AdavVegab/LoRaWAN_embeddedSystems/Präsi/Präsentation_10_12_2019.pptx

## Embedded Systems

- Energieautarke Feinstaubmessung

Thorben Kompalla
Andres Gallego
Nils Hamsen
Andres Vega
Philipp Wolters
Roman Lütkenhaus

- 10.12.2019

## Energieautarke Feinstaubmessung

- Übersicht

- Produktübersicht
- Hardwarekonzept
- Platinenlayout
- Firmware auf dem Mikrocontroller
- TTN – Anbindung und Darstellung der Daten

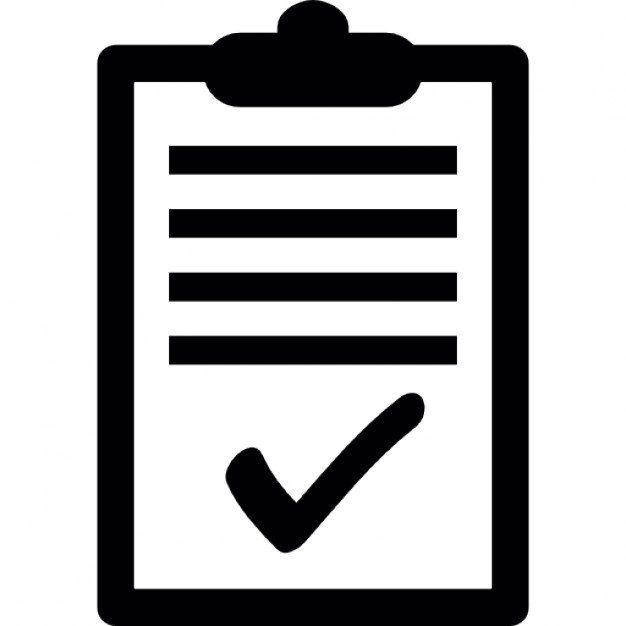
[picture p1: figure]

## Energieautarke Feinstaubmessung

- Produktübersicht

- Mobile Feinstaubmessung
- Stromversorgung über Akku und Solarzelle
- Darstellung der Messwerte auf einer Karte

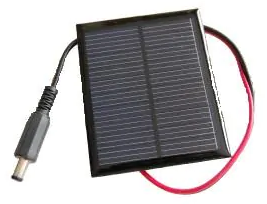
[picture p2: figure]
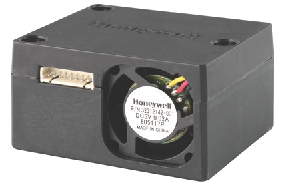
[picture p3: figure]

## Energieautarke Feinstaubmessung

- Hardwarekonzept

- Aufladung eines Akkus über Solarzelle
  - Step-Up-Converter und Lademanagement-Controller
- 3.3 V und 5 V Spannungsebenen durch Festspannungsregler
- Anbindung von Sensoren über 2 UART
- LoRaWAN-Modul über SPI angebunden

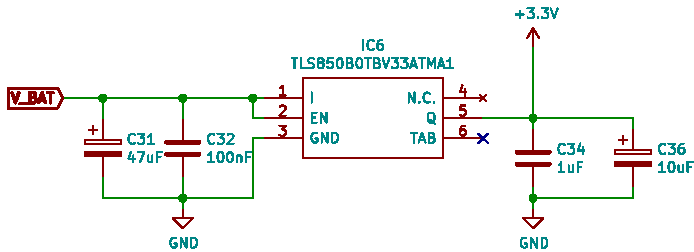
[picture p4: figure]

## Energieautarke Feinstaubmessung

- Platinenlayout

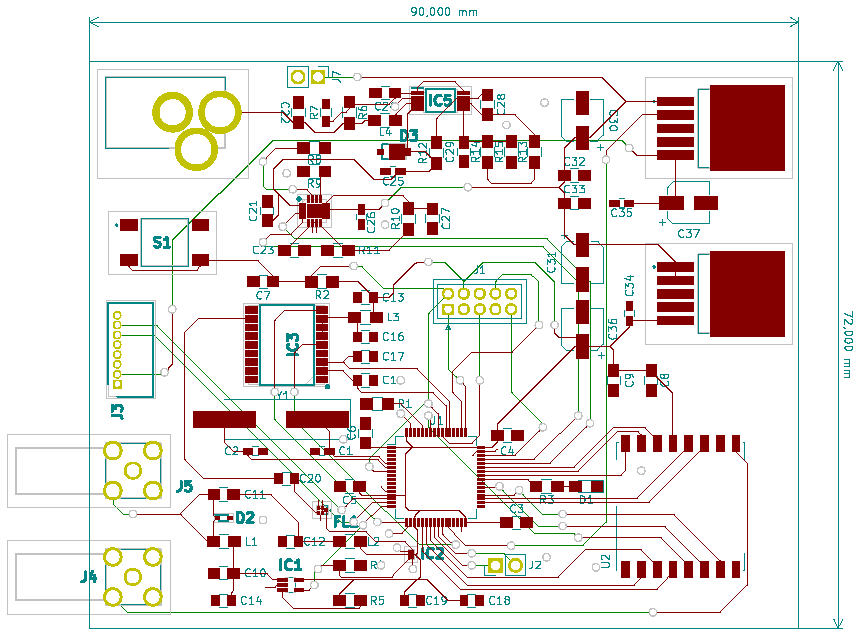
[picture p5: figure]

## Energieautarke Feinstaubmessung

- Platinenlayout

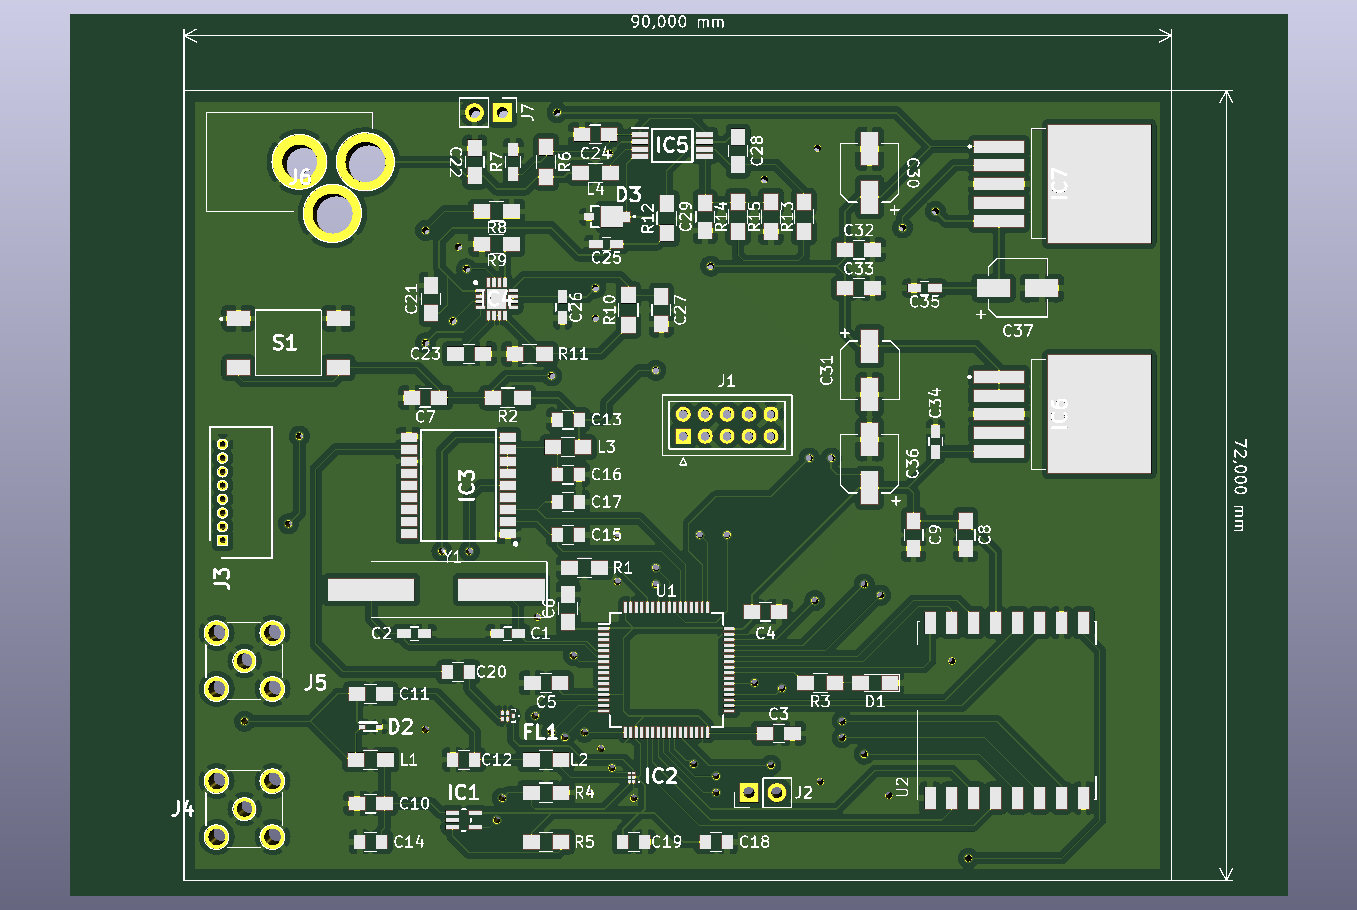
[picture p6: figure]

## Energieautarke Feinstaubmessung

- Firmware

  - LMIC-Bibliothek für LoRaWAN-Kommunikation
    - Betriebssystem regelt Jobs
    - Senden von DataFrames an TTN funktioniert
  - UART-Kommunikation mit Feinstaubsensor getestet
  - GPS-Kommunikation ist noch in Entwicklung

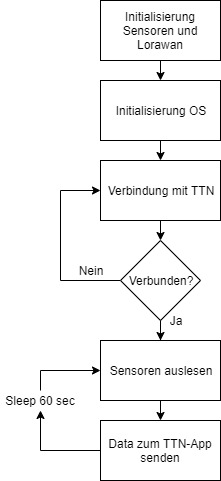
[picture p7: figure]

## Energieautarke Feinstaubmessung

- TTN – Anbindung und Darstellung der Daten
- DEMO

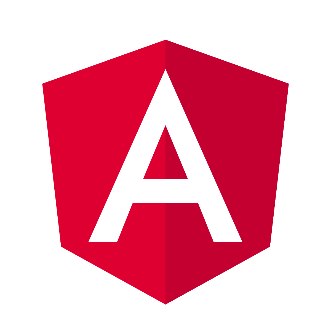
[picture p8: figure]
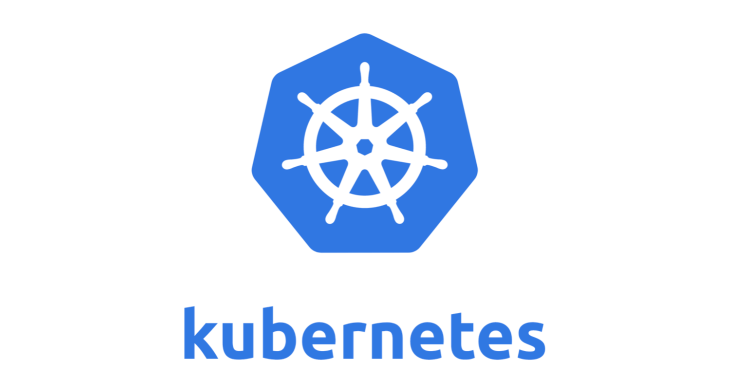
[picture p9: figure]

## Slide 9

Danke für die Aufmerksamkeit!
