AdavVegab/LoRaWAN_embeddedSystems/Präsi/SC10036_SPL.jpg

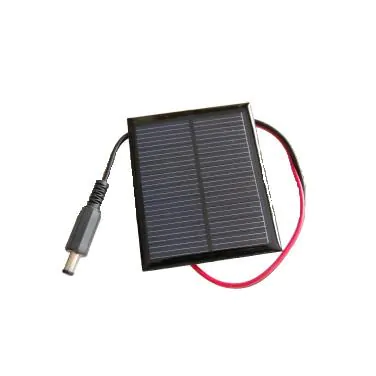
Präsi/SC10036_SPL.jpg
