AdavVegab/LoRaWAN_embeddedSystems/Schaltplan_embedded/KiCad/ES_proj_LoRaWAN_fsm/Schaltplan_embedded.png

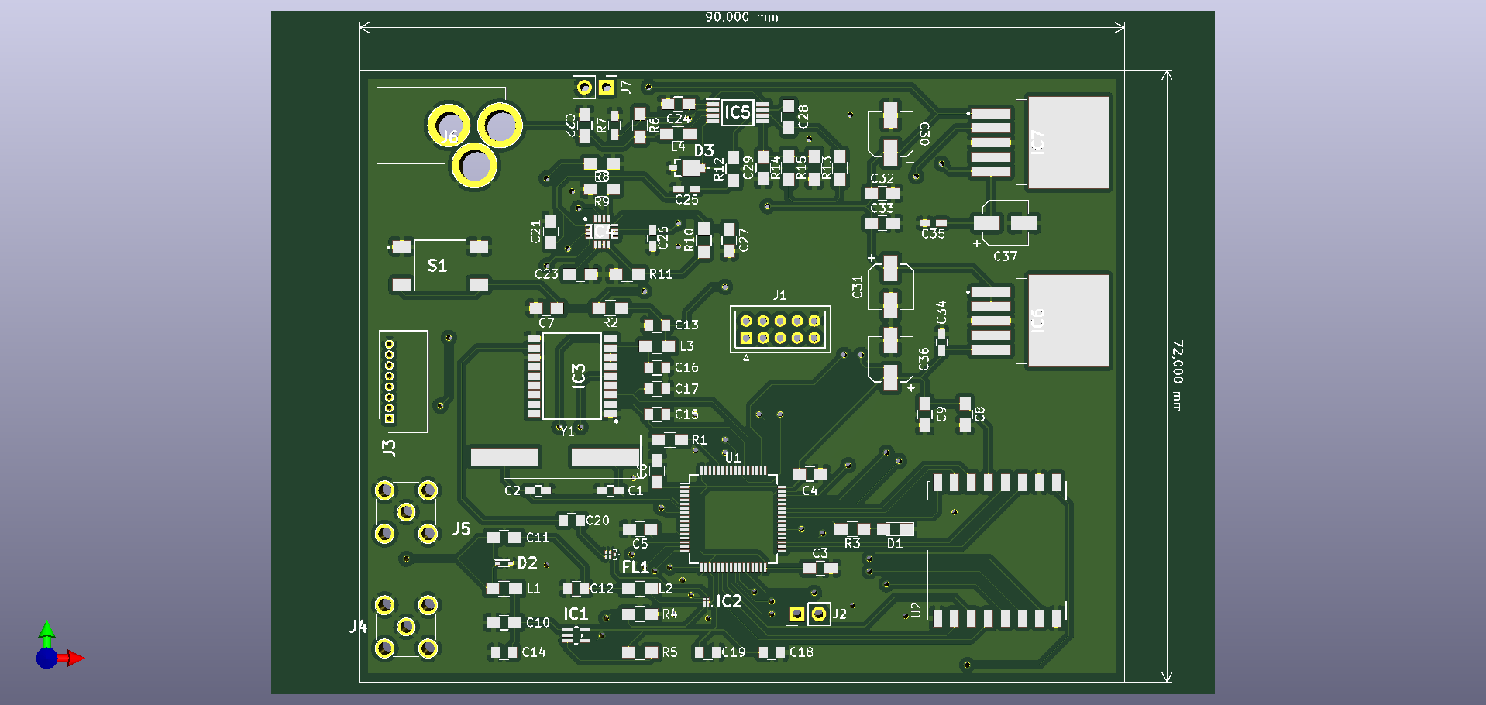
Schaltplan_embedded/KiCad/ES_proj_LoRaWAN_fsm/Schaltplan_embedded.png
