AdavVegab/LoRaWAN_embeddedSystems/Stückliste/ES_Stückliste_G3_30-10-19.xlsx

Nr. | Bauteil | Artikelnummer (Mouser) | Bezeichnung | Link | Anzahl | Stückpreis | Gesamtpreis
1 | GPS-Modul | 511-TESEO-LIV3F | Teseo-LIV3F | https://www.mouser.de/ProductDetail/STMicroelectronics/TESEO-LIV3F | 1 | 12.80 € | 12.80 €
2 | Luftqualitätssensor | 785-HPMA115SO-XXX | HPMA115S0-XXX | https://www.mouser.de/ProductDetail/Honeywell/HPMA115S0-XXX | 1 | 36.22 € | 36.22 €
3 | Akkumulator | 406-ASR00011 | ASR00011 | https://www.mouser.de/ProductDetail/TinyCircuits/ASR00011 | 1 | 2.44 € | 2.44 €
4 | Solarzelle | 375-SC10036 | SC10036 | https://www.mouser.de/ProductDetail/OSEPP-Electronics/SC10036 | 1 | 6.29 € | 6.29 €
5 | Batteriemanagement-IC | 511-SPV1040T | SPV1040T | https://www.mouser.de/ProductDetail/STMicroelectronics/SPV1040T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 | 1 | 2.84 € | 2.84 €
6 | Spannungsregler | 726-TLS850B0TBV33ATM | TLS850B0TBV33ATMA1 | https://www.mouser.de/ProductDetail/Infineon-Technologies/TLS850B0TBV33ATMA1 | 1 | 1.40 € | 1.40 €
7 | Spannungsregler | 726-TLS850B0TBV50ATM | TLS850B0TBV50ATMA1 | https://www.mouser.de/ProductDetail/Infineon-Technologies/TLS850B0TBV50ATMA1 | 1 | 1.40 € | 1.40 €
8 | Test-Board GPS | 511-X-NUCLEO-GNSS1A1 | X-NUCLEO-GNSS1A1 | https://www.mouser.de/ProductDetail/STMicroelectronics/X-NUCLEO-GNSS1A1 | 1 | 32.76 € | 32.76 €
9 | Battery charger system | 511-L6924D013TR | L6924D013TR | https://www.mouser.de/ProductDetail/STMicroelectronics/L6924D013TR?qs=sGAEpiMZZMuHTYi1bHPYEMtwCS34widI | 1 | 1.68 € | 1.68 €
10 | Antennenanschluss | 523-132289-14 | 132289-14 | https://www.mouser.de/ProductDetail/Amphenol-RF/132289-14 | 1 | 7.51 € | 7.51 €
11 | Low Noise Amplifier | 726-BGA824N6E6327 | BGA 824N6 E6327 | https://www.mouser.de/ProductDetail/Infineon-Technologies/BGA-824N6-E6327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 | 1 | 0.67 € | 0.67 €
12 | ESD protection | 511-ESDARF02-1BU2CK | ESDARF02-1BU2CK | https://www.mouser.de/ProductDetail/STMicroelectronics/ESDARF02-1BU2CK | 1 | 0.31 € | 0.31 €
13 | Low-input-voltageCurrent-limitedLoad Switches | 595-TPS22943DCKR | TPS22943DCKR | https://www.mouser.de/ProductDetail/Texas-Instruments/TPS22943DCKR | 1 | 0.91 € | 0.91 €
14 | GPS-Filter | 871-B39162B4327P810 | B39162B4327P810 | https://www.mouser.de/ProductDetail/RF360/B39162B4327P810?qs=sGAEpiMZZMvfFCidbTccA7zgl7Tx407969qKMV2MTGk%3D | 1 | 1.78 € | 1.78 €
15 | Patch Antenne | 538-206640-0001 | 206640-0001 | https://www.mouser.de/ProductDetail/Molex/206640-0001 | 1 | 5.50 € | 5.50 €
 | Kondensatoren Keramik | Unit | Verpackung | Anzahl | Anzahl Bestellt
 | 1 | nF | 805 | 4
 | 10 | nF | 805 | 2 |  | Gesamt: | 114.51 €
 | 100 | nF | 805 | 8
 | 3.9 | pF | 805 | 1
 | 20 | pF | 805 | 2
 | 56 | pF | 805 | 4
 | 120 | pF | 805 | 2
 | 1 | uF | 805 | 6
 | 2.2 | uF | 805 | 1
 | 4.7 | uF | 805 | 1
 | 10 | uF | 805 | 1
 | 47 | uF | 805 | 1
