AdavVegab/LoRaWAN_embeddedSystems/Gehäuse/mitte.stl

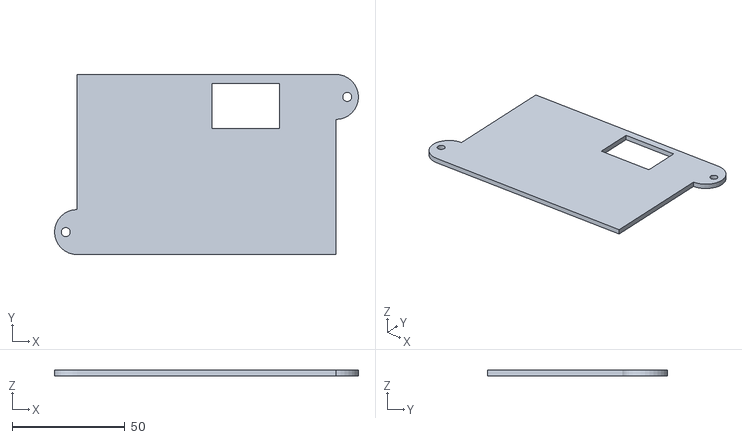
[picture p14: CAD file, 2020-02-01]
Gehäuse/mitte.stl
135.0 x 80.0 x 2.50
