AdavVegab/LoRaWAN_embeddedSystems/modell/TESEO-LIV3F.stp

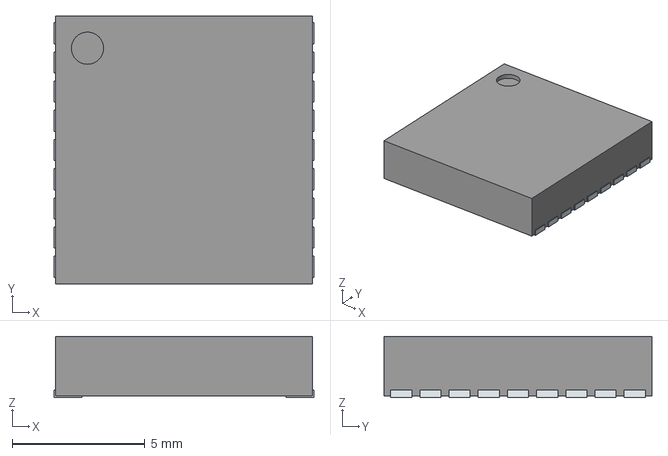
[picture p15: CAD file, 2019-11-13]
modell/TESEO-LIV3F.stp
9.80 x 10.1 x 2.30 mm
PinsArrayLR
