AdavVegab/LoRaWAN_embeddedSystems/Schaltplan_embedded/Bibliothek/modells/ECS-80-12-30Q-DS-TR.stp

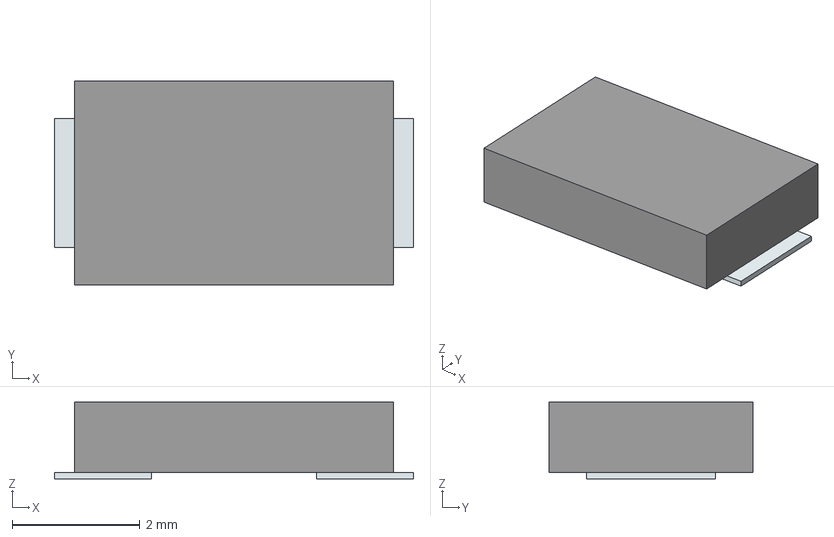
[picture p16: CAD file, 2019-12-11]
Schaltplan_embedded/Bibliothek/modells/ECS-80-12-30Q-DS-TR.stp
5.62 x 3.20 x 1.20 mm
('pin',_'1')
('pin',_'2')
