AdavVegab/LoRaWAN_embeddedSystems/Gehäuse/Gehause.FCStd

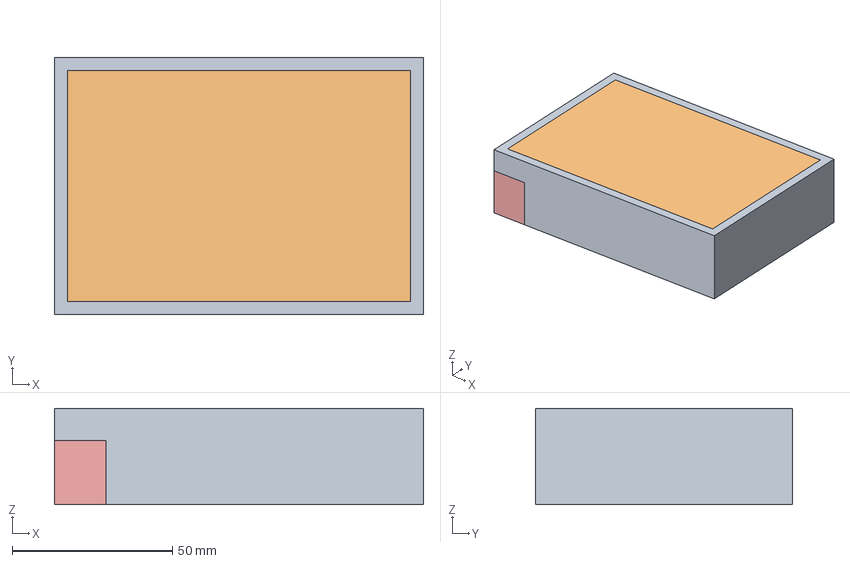
[picture p17: CAD file, 2020-02-01]
Gehäuse/Gehause.FCStd
115.0 x 80.0 x 30.0 mm
Basis
Basis_Cut
Solar
Antenne
Luftsensor
