AdavVegab/LoRaWAN_embeddedSystems/modell/L6924D.stp

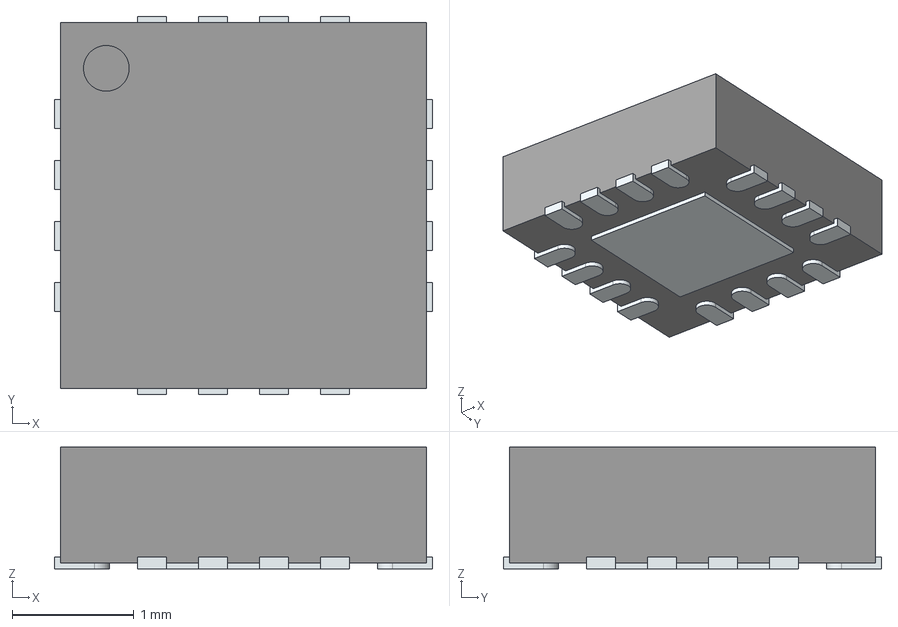
[picture p18: CAD file, 2019-11-13]
modell/L6924D.stp
3.10 x 3.10 x 1.00 mm
ThermalPin
PinsArrayLR
PinsArrayTB
