AdavVegab/LoRaWAN_embeddedSystems/Gehäuse/Case.FCStd

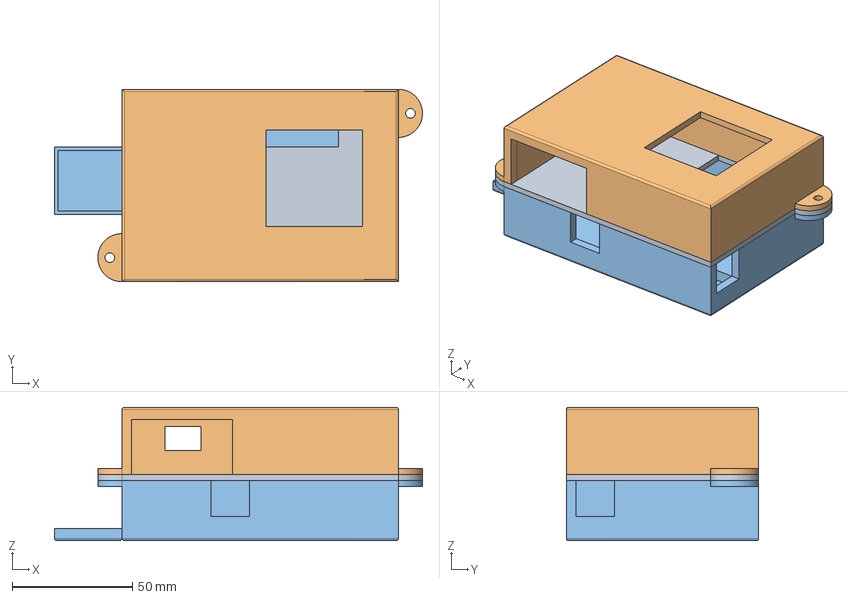
[picture p19: CAD file, 2020-02-01]
Gehäuse/Case.FCStd
153.0 x 80.0 x 55.5 mm
Mitte
Top003
Base001
