AdavVegab/LoRaWAN_embeddedSystems/modell/ESDARF02-1BU2CK.stp

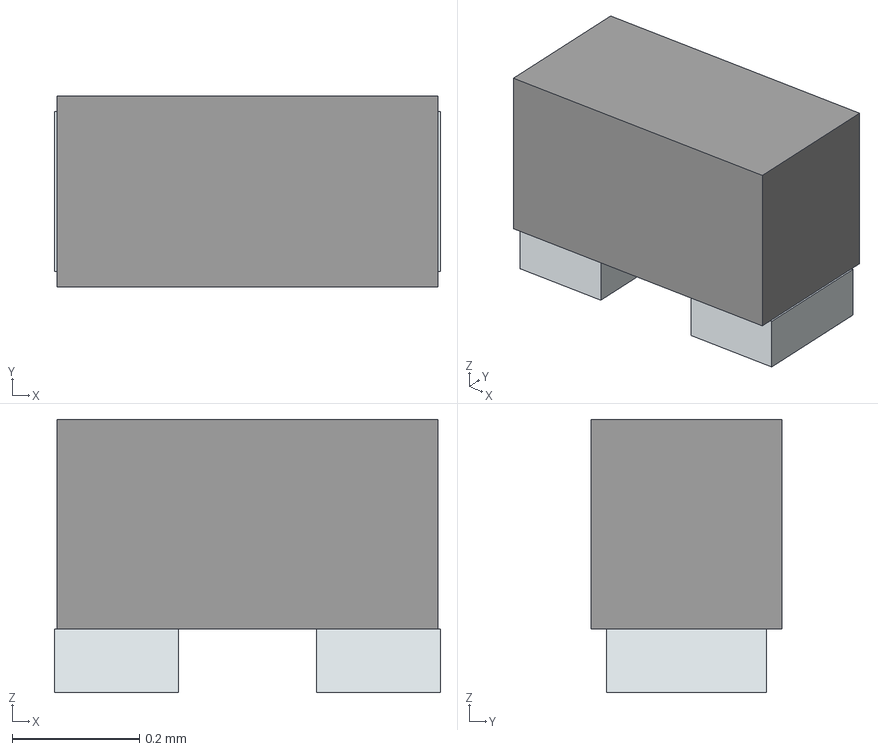
[picture p20: CAD file, 2019-11-13]
modell/ESDARF02-1BU2CK.stp
0.607 x 0.3 x 0.43 mm
('pin',_'1')
('pin',_'2')
