AdavVegab/LoRaWAN_embeddedSystems/Gehäuse/Top.stl

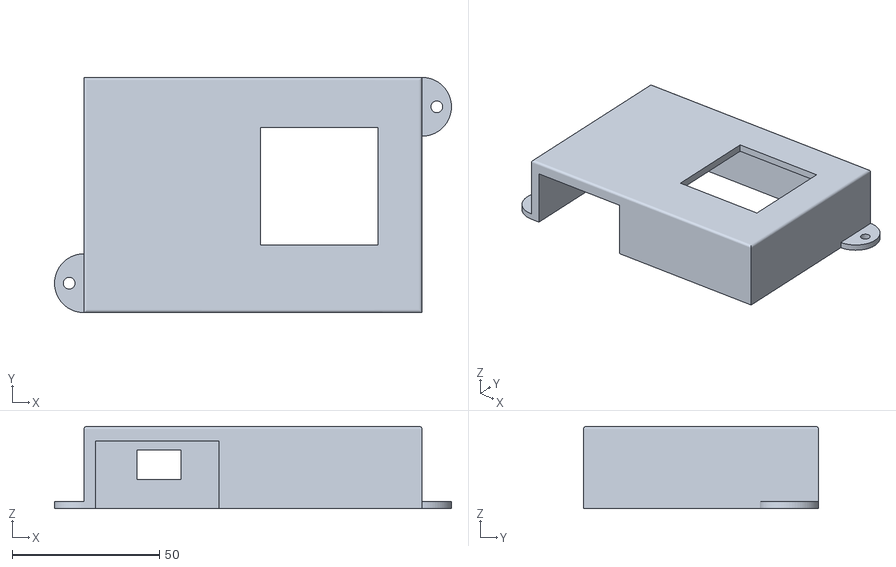
[picture p21: CAD file, 2020-02-01]
Gehäuse/Top.stl
135.0 x 80.0 x 28.0
