AdavVegab/LoRaWAN_embeddedSystems/modell/SPV1040T.stp

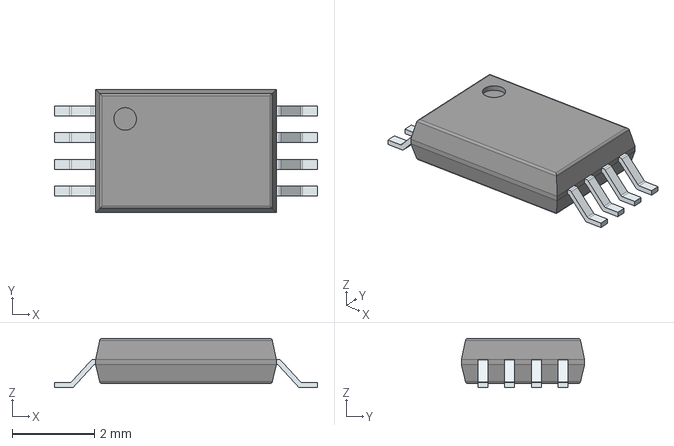
[picture p22: CAD file, 2019-11-05]
modell/SPV1040T.stp
6.40 x 3.00 x 1.20 mm
PinsArrayLR
