AdavVegab/LoRaWAN_embeddedSystems/Gehäuse/Base.stl

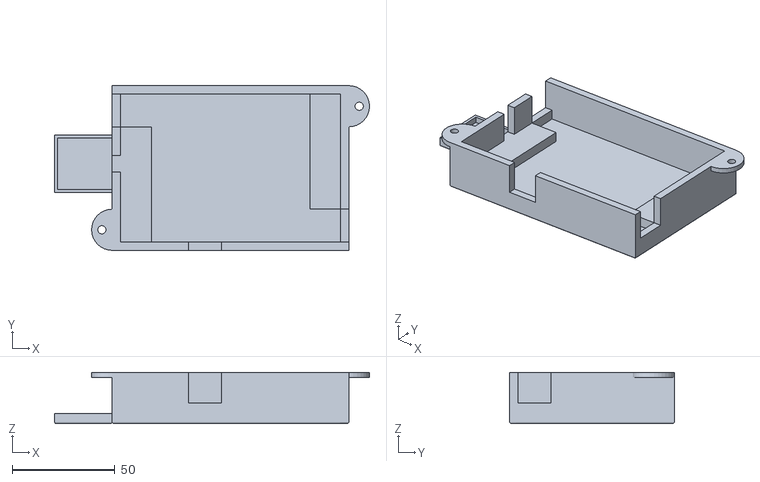
[picture p23: CAD file, 2020-02-01]
Gehäuse/Base.stl
153.0 x 80.0 x 25.0
