AdavVegab/LoRaWAN_embeddedSystems/(list of files, cad)

Other CAD files:
Bibliotheken/73100-0258.stl
Schaltplan_embedded/Bibliothek/modells/ECS-80-12-30Q-DS-TR.stl
modell/ESDARF02-1BU2CK.stl
modell/L6924D.stl
modell/SPV1040T.stl
modell/TESEO-LIV3F.stl
