AdavVegab/LoRaWAN_embeddedSystems/Präsi/Plt.pdf

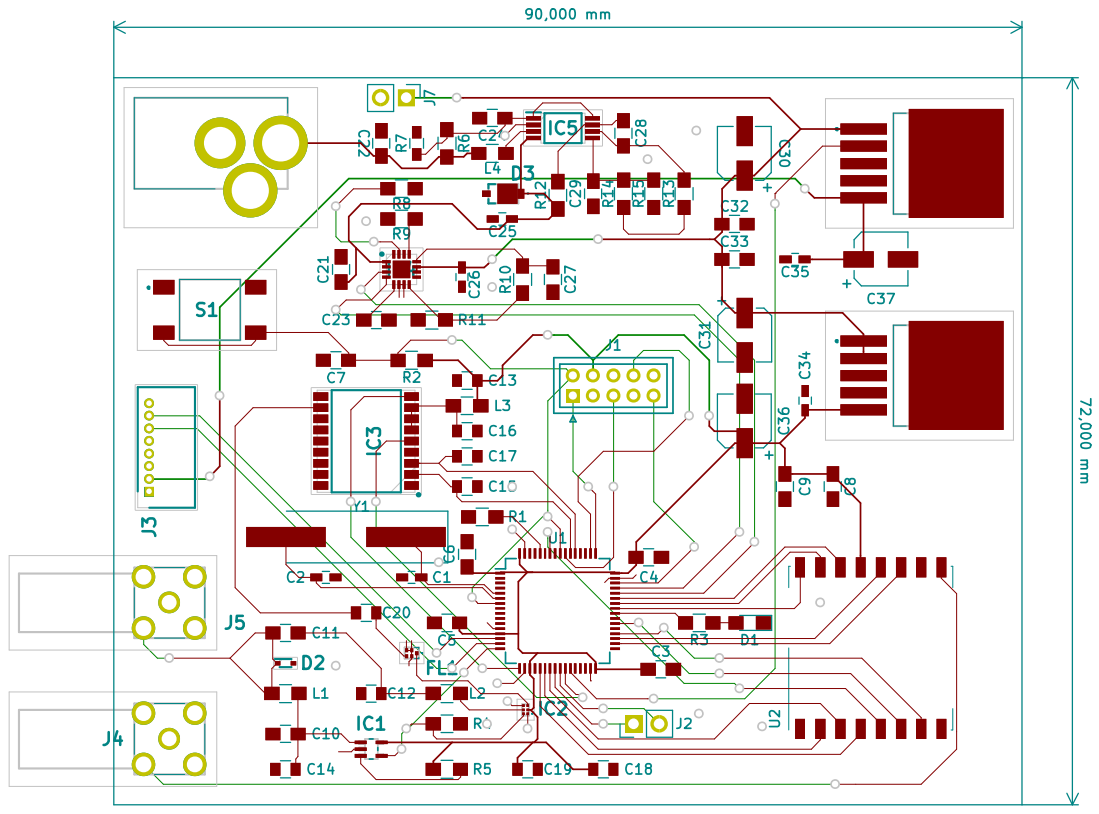
[picture p24: page 1]
