AdavVegab/LoRaWAN_embeddedSystems/(list of files, drawings)

Other design files:
Schaltplan_embedded/KiCad/ES_proj_LoRaWAN_fsm/Schaltplan_embedded.dsn
