AdavVegab/LoRaWAN_embeddedSystems/Schaltplan_embedded/KiCad/ES_proj_LoRaWAN_fsm/Schaltplan_embedded.kicad_pcb

## KiCad design Schaltplan_embedded/KiCad/ES_proj_LoRaWAN_fsm/Schaltplan_embedded.kicad_pcb (2019-12-12)

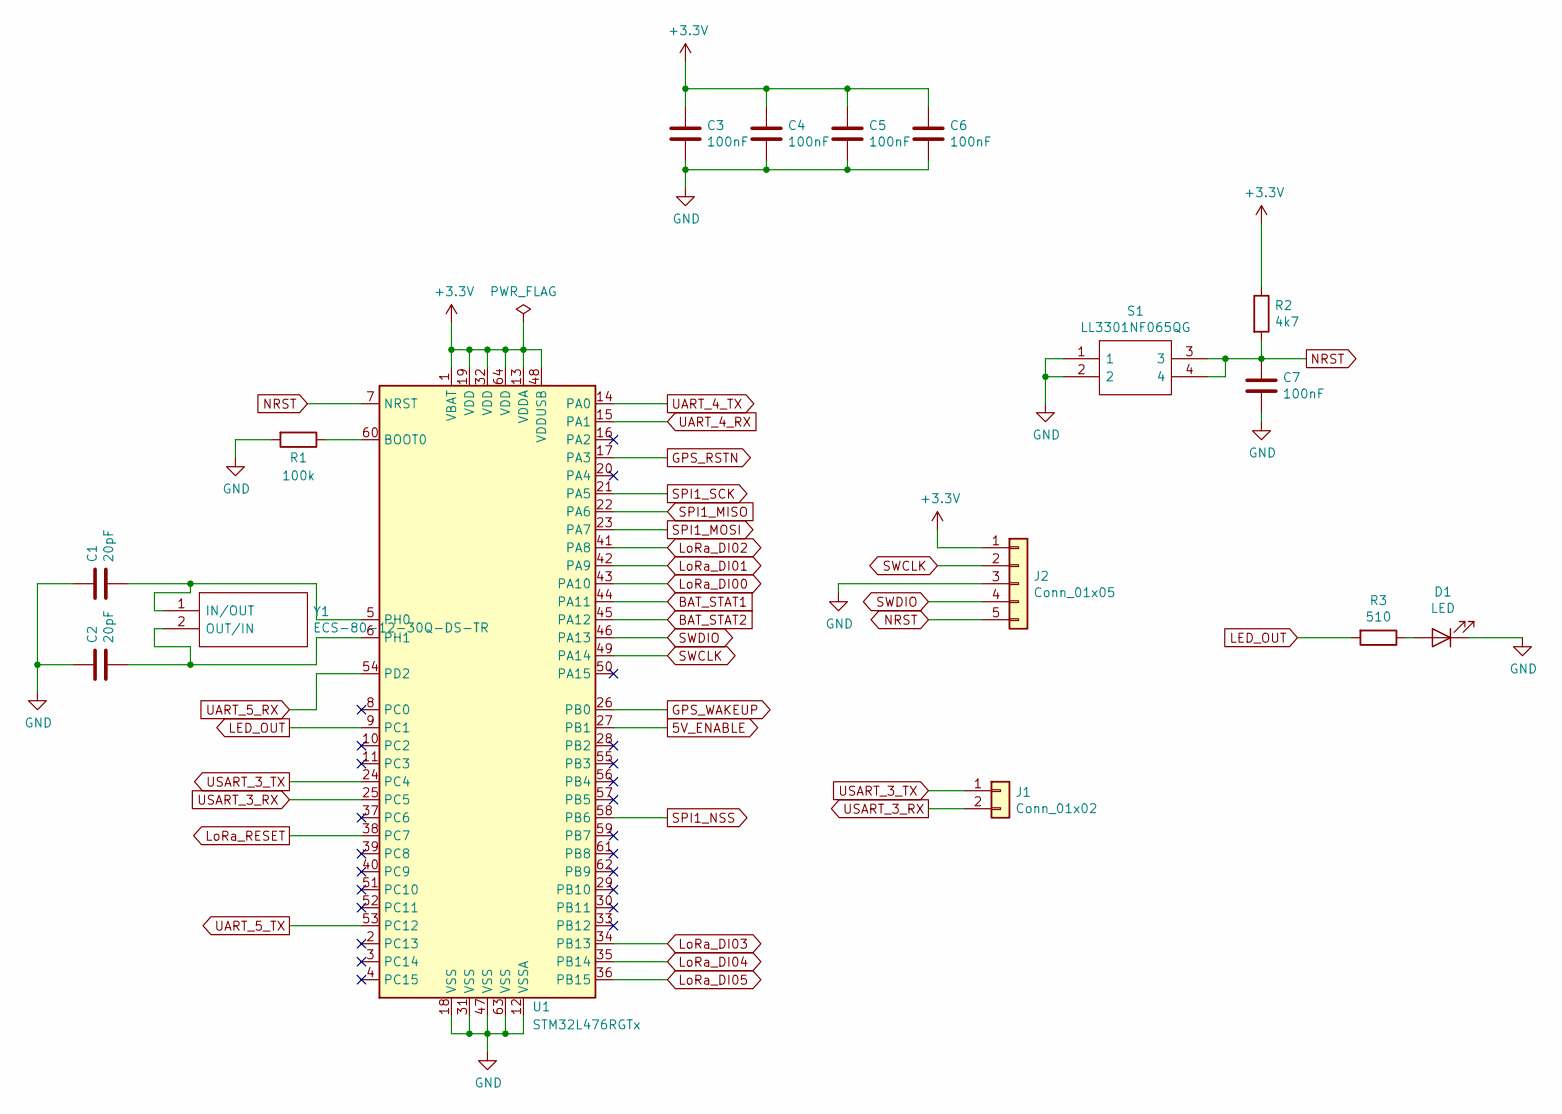
[picture p29: schematic Microcontroller.sch]

Parts:
C1, C2: 20pF; C_0603_HandSoldering
C3, C4, C5, C6, C7: 100nF; C_0805_HandSoldering
D1: LED; LED_0805_HandSoldering
J1: Conn_01x02; PinHeader_1x02_P2.54mm_Vertical
J2: Conn_01x05; PinHeader_1x05_P2.54mm_Vertical
R1: 100k; R_0805_HandSoldering
R2: 4k7; R_0805_HandSoldering
R3: 510; R_0805_HandSoldering
S1: LL3301NF065QG; Mouser Part Number 612-LL3301NF065QG
U1: STM32L476RGTx; LQFP-64_10x10mm_Pitch0.5mm
Y1: ECS-80-12-30Q-DS-TR; Quarz; Mouser Part Number 520-80-12-30Q-DST

Connections:
5V_ENABLE: U1.27 (PB1); also elsewhere on the board
+3V3: C3.1, C4.1, C5.1, C6.1, J2.1, R2.1, U1.1 (VBAT), U1.13 (VDDA), U1.19 (VDD), U1.32 (VDD), U1.48 (VDDUSB), U1.64 (VDD); also elsewhere on the board
BAT_STAT1: U1.44 (PA11); also elsewhere on the board
BAT_STAT2: U1.45 (PA12); also elsewhere on the board
GND: C1.1, C2.1, C3.2, C4.2, C5.2, C6.2, C7.2, D1.1 (K), J2.3, R1.2, S1.1, S1.2, U1.12 (VSSA), U1.18 (VSS), U1.31 (VSS), U1.47 (VSS), U1.63 (VSS); also elsewhere on the board
GPS_RSTN: U1.17 (PA3); also elsewhere on the board
GPS_WAKEUP: U1.26 (PB0); also elsewhere on the board
LED_OUT: R3.2, U1.9 (PC1)
LoRa_DI00: U1.43 (PA10); also elsewhere on the board
LoRa_DI01: U1.42 (PA9); also elsewhere on the board
LoRa_DI02: U1.41 (PA8); also elsewhere on the board
LoRa_DI03: U1.34 (PB13); also elsewhere on the board
LoRa_DI04: U1.35 (PB14); also elsewhere on the board
LoRa_DI05: U1.36 (PB15); also elsewhere on the board
LoRa_RESET: U1.38 (PC7); also elsewhere on the board
NRST: C7.1, J2.5, R2.2, S1.3, S1.4, U1.7 (NRST)
unnamed: C1.2, U1.5 (PH0), Y1.1 (IN/OUT)
unnamed: C2.2, U1.6 (PH1), Y1.2 (OUT/IN)
unnamed: D1.2 (A), R3.1
unnamed: R1.1, U1.60 (BOOT0)
SPI1_MISO: U1.22 (PA6); also elsewhere on the board
SPI1_MOSI: U1.23 (PA7); also elsewhere on the board
SPI1_NSS: U1.58 (PB6); also elsewhere on the board
SPI1_SCK: U1.21 (PA5); also elsewhere on the board
SWCLK: J2.2, U1.49 (PA14)
SWDIO: J2.4, U1.46 (PA13)
UART_4_RX: U1.15 (PA1); also elsewhere on the board
UART_4_TX: U1.14 (PA0); also elsewhere on the board
UART_5_RX: U1.54 (PD2); also elsewhere on the board
UART_5_TX: U1.53 (PC12); also elsewhere on the board
USART_3_RX: J1.2, U1.25 (PC5)
USART_3_TX: J1.1, U1.24 (PC4)

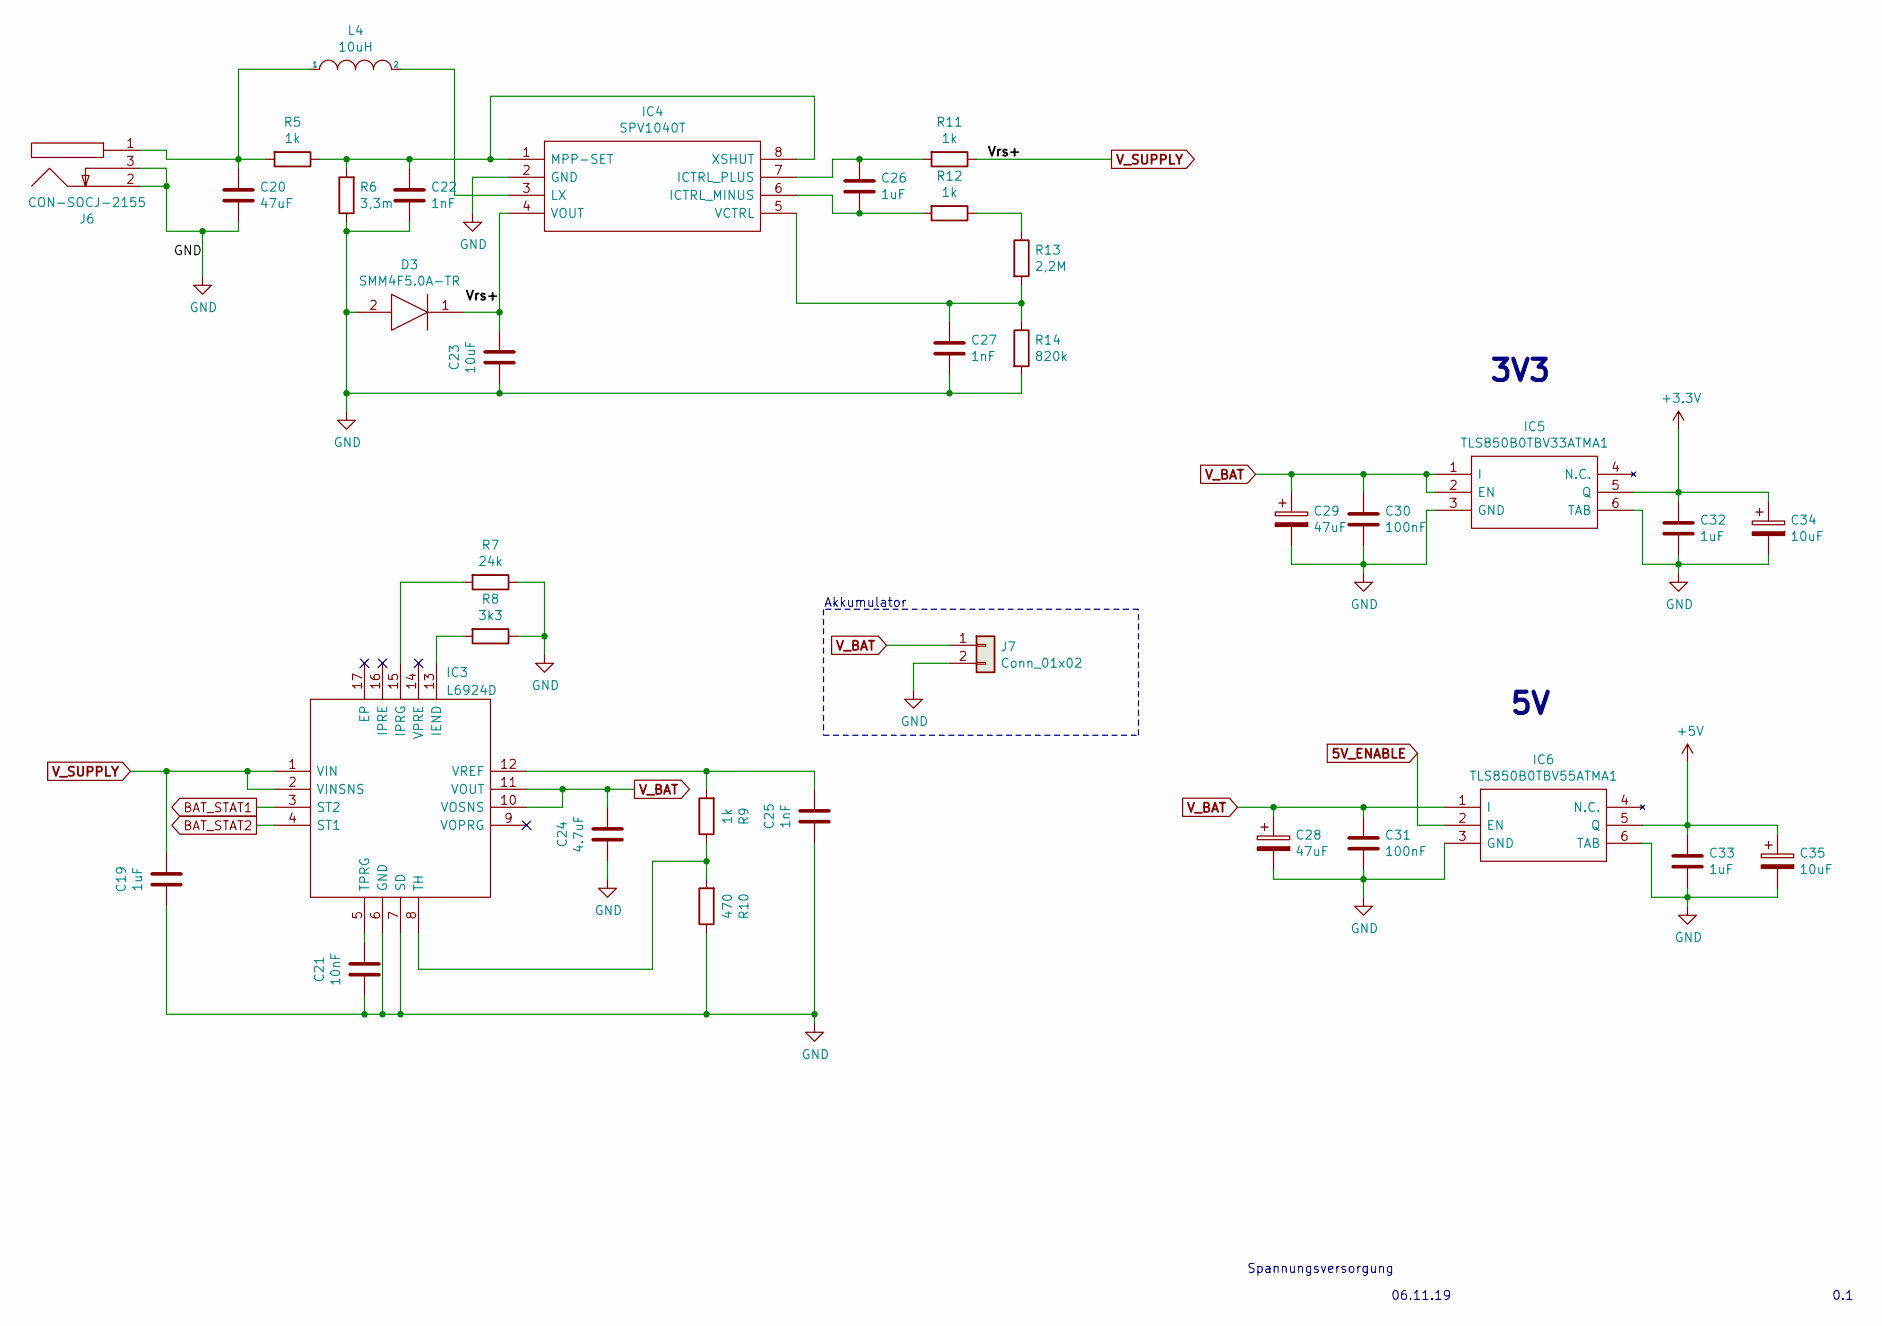
[picture p30: schematic Spannungsversorgung.sch]

Parts:
C19, C26: 1uF; C_0805_HandSoldering
C20: 47uF; C_0805_HandSoldering
C21: 10nF; C_0805_HandSoldering
C22, C25, C27: 1nF; C_0805_HandSoldering
C23: 10uF; C_0603_HandSoldering
C24: 4.7uF; C_0603_HandSoldering
C28, C29: 47uF; CP_Elec_5x5.3
C30, C31: 100nF; C_0805_HandSoldering
C32, C33: 1uF; C_0603_HandSoldering
C34, C35: 10uF; CP_Elec_5x5.3
D3: SMM4F5.0A-TR; STMITE; Mouser Part Number 511-SMM4F5.0A-TR
IC3: L6924D; QFN50P300X300X100-17N-D; Mouser Part Number 511-L6924D
IC4: SPV1040T; SOP65P640X120-8N; Mouser Part Number 511-SPV1040T
IC5: TLS850B0TBV33ATMA1; Mouser Part Number 726-TLS850B0TBV33ATM
IC6: TLS850B0TBV55ATMA1; TLS850B0TBV33ATMA1; Mouser Part Number 726-TLS850B0TBV33ATM
J6: CON-SOCJ-2155; CONSOCJ2155; Mouser Part Number 992-CON-SOCJ-2155
J7: Conn_01x02; Pin_Header_Straight_1x02_Pitch2.54mm
L4: 10uH; L_0805_2012Metric_Pad1.15x1.40mm_HandSolder
R5, R9, R11, R12: 1k; R_0805_HandSoldering
R6: 3,3m; R_0603_HandSoldering
R7: 24k; R_0805_HandSoldering
R8: 3k3; R_0805_HandSoldering
R10: 470; R_0805_HandSoldering
R13: 2,2M; R_0805_HandSoldering
R14: 820k; R_0805_HandSoldering

Connections:
5V_ENABLE: IC6.2 (EN); also elsewhere on the board
+3V3: C32.1, C34.1, IC5.5 (Q); also elsewhere on the board
+5V: C33.1, C35.1, IC6.5 (Q); also elsewhere on the board
BAT_STAT1: IC3.3 (ST2); also elsewhere on the board
BAT_STAT2: IC3.4 (ST1); also elsewhere on the board
GND: C19.2, C20.2, C21.2, C22.2, C23.2, C24.2, C25.2, C27.1, C28.2, C29.2, C30.2, C31.2, C32.2, C33.2, C34.2, C35.2, D3.2, IC3.6 (GND), IC3.7 (SD), IC4.2 (GND), IC5.3 (GND), IC5.6 (TAB), IC6.3 (GND), IC6.6 (TAB), J6.2, J6.3, J7.2, R6.1, R7.1, R8.1, R10.1, R14.2; also elsewhere on the board
unnamed: C20.1, J6.1, L4.1, R5.2
unnamed: C21.1, IC3.5 (TPRG)
unnamed: C22.1, IC4.1 (MPP-SET), IC4.8 (XSHUT), R5.1, R6.2
unnamed: C25.1, IC3.12 (VREF), R9.2
unnamed: C26.1, IC4.7 (ICTRL_PLUS), R11.2
unnamed: C26.2, IC4.6 (ICTRL_MINUS), R12.2
unnamed: C27.2, IC4.5 (VCTRL), R13.2, R14.1
unnamed: IC3.8 (TH), R9.1, R10.2
unnamed: IC3.13 (IEND), R8.2
unnamed: IC3.15 (IPRG), R7.2
unnamed: IC4.3 (LX), L4.2
unnamed: R12.1, R13.1
V_BAT: C24.1, C28.1, C29.1, C30.1, C31.1, IC3.10 (VOSNS), IC3.11 (VOUT), IC5.1 (I), IC5.2 (EN), IC6.1 (I), J7.1
V_SUPPLY: C19.1, C23.1, D3.1, IC3.1 (VIN), IC3.2 (VINSNS), IC4.4 (VOUT), R11.1

Notes on the sheet:
3V3
Spannungsversorgung
06.11.19
0.1
Akkumulator

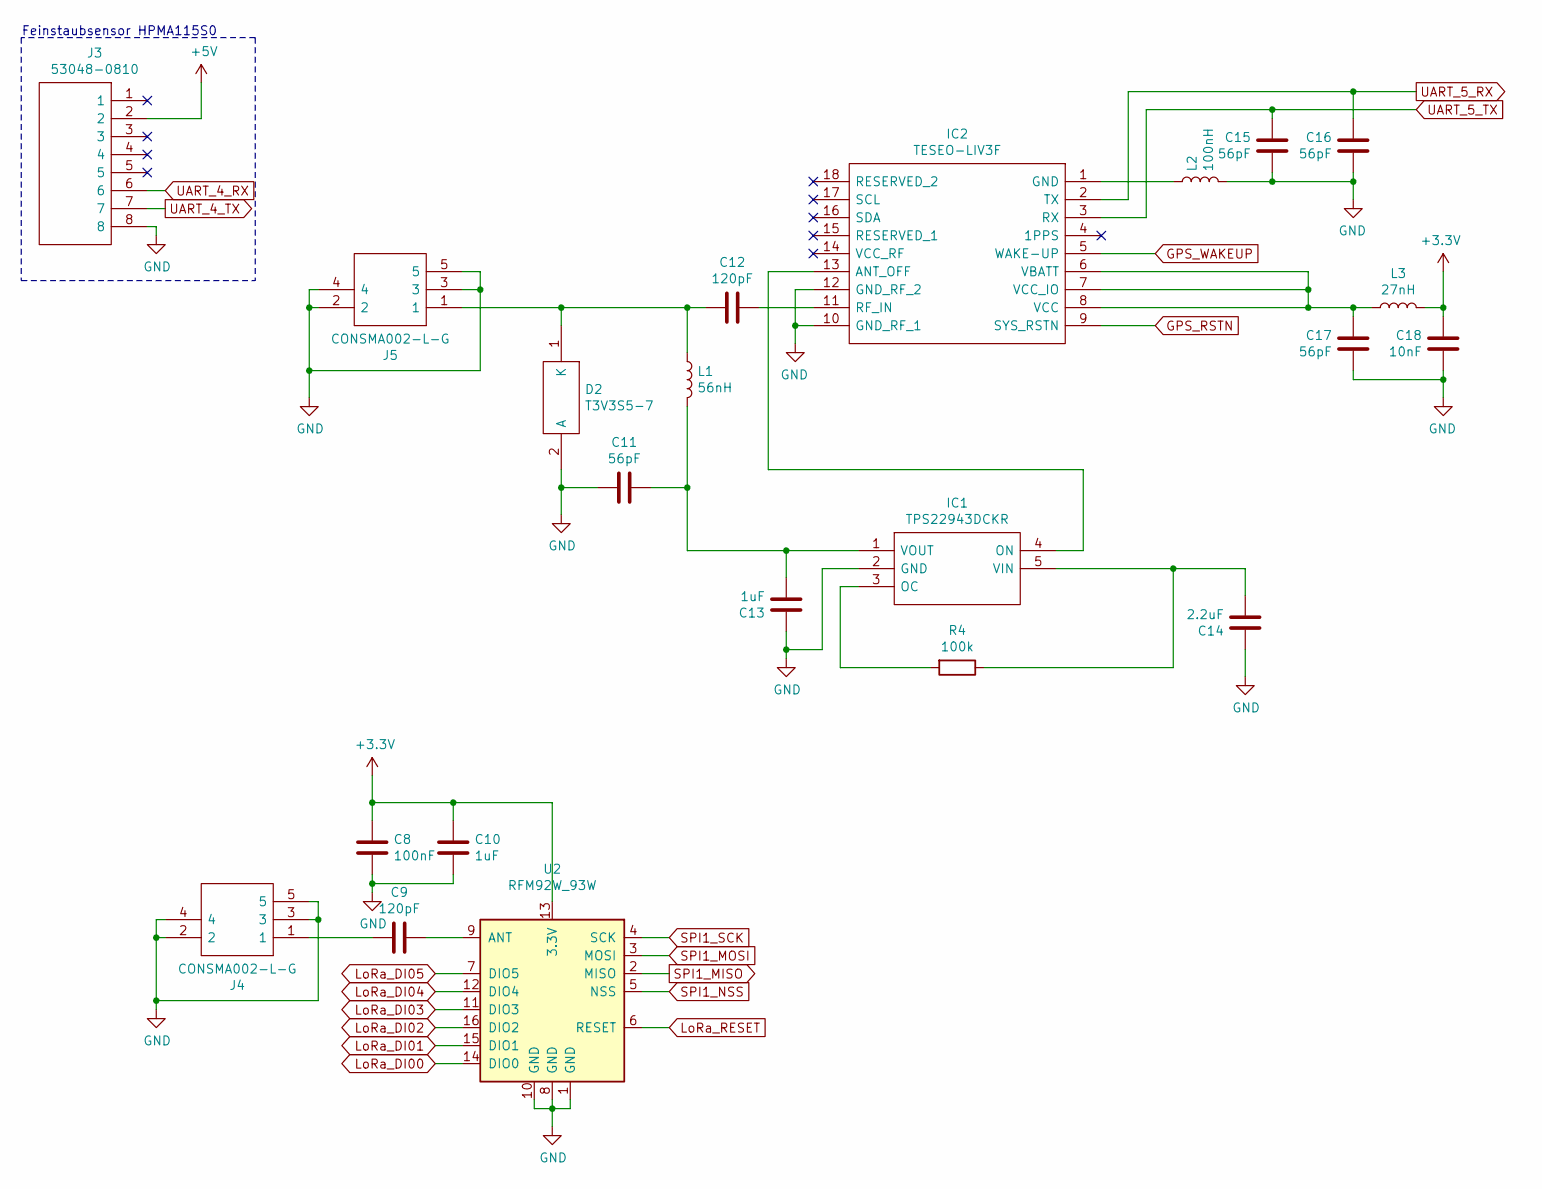
[picture p31: schematic Sensorik.sch]

Parts:
C8: 100nF; C_0805_HandSoldering
C9, C12: 120pF; C_0805_2012Metric_Pad1.15x1.40mm_HandSolder
C10: 1uF; C_0805_HandSoldering
C11: 56pF; C_0805_HandSoldering
C13: 1uF; C_0805_2012Metric_Pad1.15x1.40mm_HandSolder
C14: 2.2uF; C_0805_2012Metric_Pad1.15x1.40mm_HandSolder
C15, C16, C17: 56pF; C_0805_2012Metric_Pad1.15x1.40mm_HandSolder
C18: 10nF; C_0805_2012Metric_Pad1.15x1.40mm_HandSolder
D2: T3V3S5-7; SODFL1608X65N; Mouser Part Number 621-T3V3S5-7
IC1: TPS22943DCKR; SOT65P210X110-5N; Mouser Part Number 595-TPS22943DCKR
IC2: TESEO-LIV3F; SON110P970X1010X230-18N; Mouser Part Number 511-TESEO-LIV3F
J3: 53048-0810; SHDR8W35P0X125_1X8_1175X550X370P; Mouser Part Number 538-53048-0810
J4, J5: CONSMA002-L-G; CONSMA002LG; Mouser Part Number 712-CONSMA002-L-G
L1: 56nH; L_0805_2012Metric_Pad1.15x1.40mm_HandSolder
L2: 100nH; L_0805_2012Metric_Pad1.15x1.40mm_HandSolder
L3: 27nH; L_0805_2012Metric_Pad1.15x1.40mm_HandSolder
R4: 100k; R_0805_HandSoldering
U2: RFM92W_93W; Hopref_RFM9XW_SMD

Connections:
+3V3: C8.2, C10.2, C18.1, L3.1, U2.13 (3.3V); also elsewhere on the board
+5V: J3.2; also elsewhere on the board
GND: C8.1, C10.1, C11.2, C13.2, C14.2, C15.2, C16.2, C17.2, C18.2, D2.2 (A), IC1.2 (GND), IC2.10 (GND_RF_1), IC2.12 (GND_RF_2), J3.8, J4.2, J4.3, J4.4, J4.5, J5.2, J5.3, J5.4, J5.5, L2.2, U2.1 (GND), U2.8 (GND), U2.10 (GND); also elsewhere on the board
GPS_RSTN: IC2.9 (SYS_RSTN); also elsewhere on the board
GPS_WAKEUP: IC2.5 (WAKE-UP); also elsewhere on the board
LoRa_DI00: U2.14 (DIO0); also elsewhere on the board
LoRa_DI01: U2.15 (DIO1); also elsewhere on the board
LoRa_DI02: U2.16 (DIO2); also elsewhere on the board
LoRa_DI03: U2.11 (DIO3); also elsewhere on the board
LoRa_DI04: U2.12 (DIO4); also elsewhere on the board
LoRa_DI05: U2.7 (DIO5); also elsewhere on the board
LoRa_RESET: U2.6 (RESET); also elsewhere on the board
unnamed: C9.1, U2.9 (ANT)
unnamed: C9.2, J4.1
unnamed: C11.1, C13.1, IC1.1 (VOUT), L1.2
unnamed: C12.1, IC2.11 (RF_IN)
unnamed: C12.2, D2.1 (K), J5.1, L1.1
unnamed: C14.1, IC1.5 (VIN), R4.1
unnamed: C17.1, IC2.6 (VBATT), IC2.7 (VCC_IO), IC2.8 (VCC), L3.2
unnamed: IC1.3 (OC), R4.2
unnamed: IC1.4 (ON), IC2.13 (ANT_OFF)
unnamed: IC2.1 (GND), L2.1
SPI1_MISO: U2.2 (MISO); also elsewhere on the board
SPI1_MOSI: U2.3 (MOSI); also elsewhere on the board
SPI1_NSS: U2.5 (NSS); also elsewhere on the board
SPI1_SCK: U2.4 (SCK); also elsewhere on the board
UART_4_RX: J3.6; also elsewhere on the board
UART_4_TX: J3.7; also elsewhere on the board
UART_5_RX: C16.1, IC2.2 (TX); also elsewhere on the board
UART_5_TX: C15.1, IC2.3 (RX); also elsewhere on the board

Notes on the sheet:
Feinstaubsensor HPMA115S0

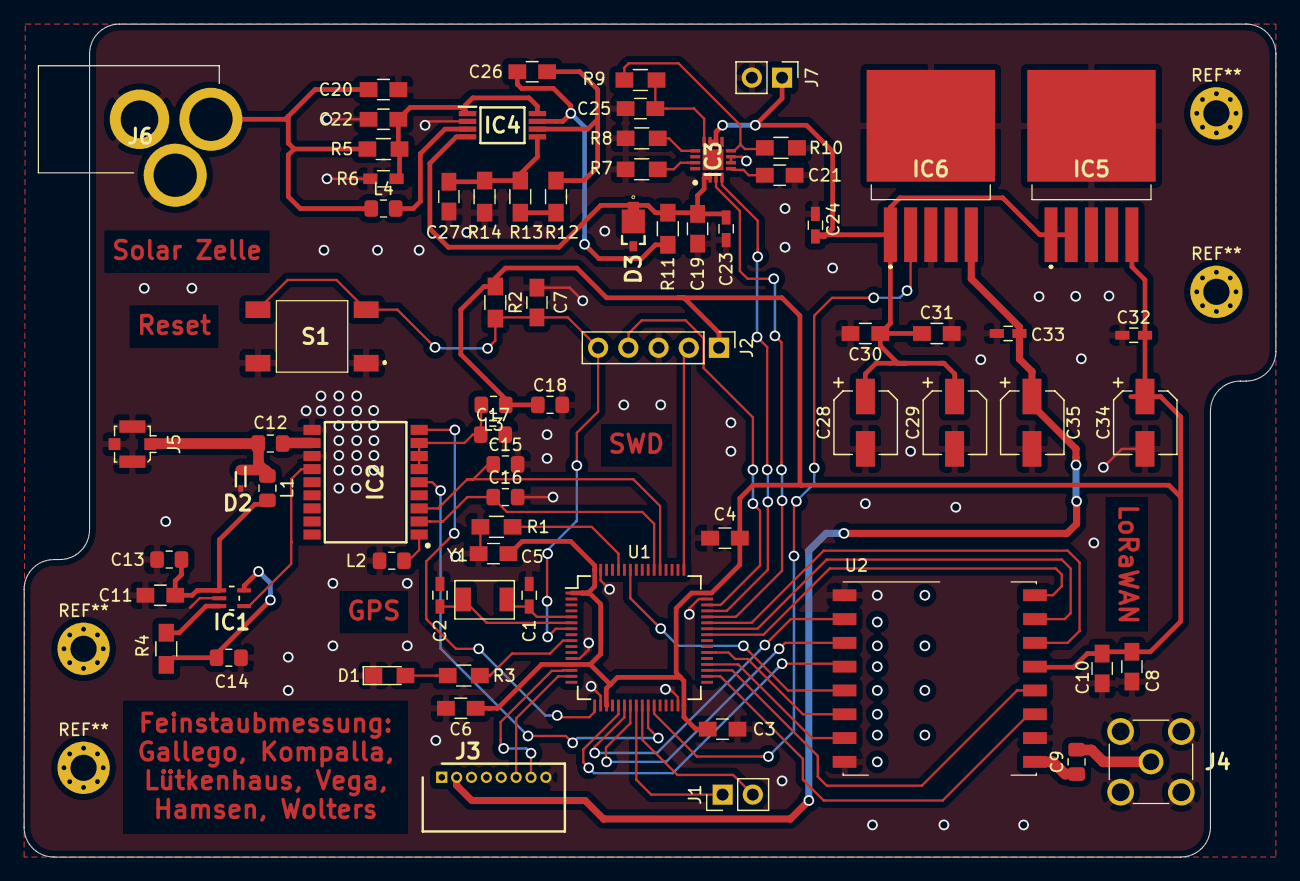
[picture p32: board Schaltplan_embedded.kicad_pcb from above]

Board: 2 copper layers, 105.2 x 70.0 mm, 73 parts (0 on the bottom side), 57 nets.
