AdavVegab/LoRaWAN_embeddedSystems/Firmware/FW_Feinstaubmessung/Core/Src/main.c

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

/* Includes ------------------------------------------------------------------*/
#include "main.h"

/* USER CODE BEGIN Includes */
#include "lmic.h"
#include "debug.h"
#include "stm32hpmlib.h"
#include "user_config.h"
/* USER CODE END Includes */


/* USER CODE END PV */

void SystemClock_Config(void);
static void MX_GPIO_Init(void);
static void MX_SPI1_Init(void);
static void MX_TIM4_Init(void);
static void MX_USART2_UART_Init(void);
static void MX_UART4_Init(void);
/* USER CODE BEGIN 0 */

// provide application router ID (8 bytes, LSBF)
void os_getArtEui (u1_t* buf) {
    memcpy(buf, APPEUI, 8);
}

// provide device ID (8 bytes, LSBF)
void os_getDevEui (u1_t* buf) {
    memcpy(buf, DEVEUI, 8);
}

// provide device key (16 bytes)
void os_getDevKey (u1_t* buf) {
    memcpy(buf, DEVKEY, 16);
}


void initfunc (osjob_t* j) {
    // reset MAC state
    LMIC_reset();
    // start joining
    LMIC_startJoining();
    // init done - onEvent() callback will be invoked...
}


static osjob_t reportjob;


static void reportfunc (osjob_t* j) {

    // read sensors
	int pm25 = 0;
	int pm10 = 0;
	hpmStartParticleMeasurement();
	HAL_Delay(measure);
	hpmReadResults(&pm25,&pm10);
	hpmStopParticleMeasurement();

    // prepare and schedule data for transmission
    LMIC.frame[0] = pm25 >> 8;
    LMIC.frame[1] = pm25;
    LMIC.frame[2] = pm10 >> 8;
    LMIC.frame[3] = pm10;

    // send data
    LMIC_setTxData2(1, LMIC.frame, 4, 0); // (port 1, 4 bytes, unconfirmed)

    // reschedule job
    os_setTimedCallback(j, os_getTime()+sec2osticks(interval), reportfunc);
}


//////////////////////////////////////////////////
// LMIC EVENT CALLBACK
//////////////////////////////////////////////////

void onEvent (ev_t ev) {
    debug_event(ev);

    switch(ev) {

      // network joined, session established
      case EV_JOINING:
       	  debug_str("try joining\r\n");
       	  break;
      case EV_JOINED:
          //debug_led(1);
    	  debug_str("joined\r\n");
          // kick-off periodic sensor job
          reportfunc(&reportjob);
          break;
      case EV_JOIN_FAILED:
    	  debug_str("join failed\r\n");
    	  break;
      case EV_SCAN_TIMEOUT:
    	  debug_str("EV_SCAN_TIMEOUT\r\n");
		  break;
	  case EV_BEACON_FOUND:
		  debug_str("EV_BEACON_FOUND\r\n");
		  break;
	  case EV_BEACON_MISSED:
		  debug_str("EV_BEACON_MISSED\r\n");
		  break;
	  case EV_BEACON_TRACKED:
		  debug_str("EV_BEACON_TRACKED\r\n");
		  break;
	  case EV_RFU1:
		  debug_str("EV_RFU1\r\n");
		  break;
	  case EV_REJOIN_FAILED:
		  debug_str("EV_REJOIN_FAILED\r\n");
		  break;
	  case EV_TXCOMPLETE:
		  debug_str("EV_TXCOMPLETE (includes waiting for RX windows)\r\n");
		  if (LMIC.txrxFlags & TXRX_ACK)
			  debug_str("Received ack\r\n");
		  if (LMIC.dataLen) {
			  debug_str("Received ");
			  //debug_str(LMIC.dataLen);
			  debug_str(" bytes of payload\r\n");
		  }
		  break;
	  case EV_LOST_TSYNC:
		  debug_str("EV_LOST_TSYNC\r\n");
		  break;
	  case EV_RESET:
		  debug_str("EV_RESET\r\n");
		  break;
	  case EV_RXCOMPLETE:
		  // data received in ping slot
		  debug_str("EV_RXCOMPLETE\r\n");
		  break;
	  case EV_LINK_DEAD:
		  debug_str("EV_LINK_DEAD\r\n");
		  break;
	  case EV_LINK_ALIVE:
		  debug_str("EV_LINK_ALIVE\r\n");
		  break;
	  default:
		   debug_str("\r\n");
		  break;
    }
}
/* USER CODE END 0 */

/**
  * @brief  The application entry point.
  * @retval int
  */
int main(void)
{
  

  /* MCU Configuration--------------------------------------------------------*/

  /* Reset of all peripherals, Initializes the Flash interface and the Systick. */
  HAL_Init();

  /* Configure the system clock */
  SystemClock_Config();

  /* Initialize all configured peripherals */
  MX_GPIO_Init();
  MX_SPI1_Init();
  MX_TIM4_Init();
  MX_USART2_UART_Init();
  MX_UART4_Init();
  /* USER CODE BEGIN 2 */
  HAL_TIM_Base_Start_IT(&htim4);    // <-----------  change to your setup
  __HAL_SPI_ENABLE(&hspi1);         // <-----------  change to your setup

  osjob_t initjob;

  // initialize runtime env
  os_init();

  // initialize debug library
  debug_init();

  // Configure UART for Air-Sensor
  debug_str("Configuring Sensor\r\n");
  hpmSetUart(&huart4);
  hpmStopAutoSend();
  hpmStopParticleMeasurement();
  // setup initial job
   os_setCallback(&initjob, initfunc);
  // execute scheduled jobs and events
  os_runloop();
  // (not reached)
  return 0;


  /* USER CODE END 2 */

  /* Infinite loop */
  /* USER CODE BEGIN WHILE */
  while (1)
  {
    /* USER CODE END WHILE */

    /* USER CODE BEGIN 3 */
  }
  /* USER CODE END 3 */
}

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
