AdavVegab/LoRaWAN_embeddedSystems/Firmware/FW_Feinstaubmessung/FW_Feinstaubmessung.ioc

Mcu.UserName=STM32L476RGTx
PA0.Signal=UART4_TX
PA1.Signal=UART4_RX
PA10.GPIO_Label=DIO0
PA10.Signal=GPXTI10
PA2.Signal=USART2_TX
PA3.Signal=USART2_RX
PA5.Signal=SPI1_SCK
PA6.Signal=SPI1_MISO
PA7.Signal=SPI1_MOSI
PA8.GPIO_Label=DIO2
PA8.Signal=GPXTI8
PA9.GPIO_Label=DIO1
PA9.Signal=GPXTI9
PB6.GPIO_Label=NSS
PB6.Signal=GPIO_Output
PC7.GPIO_Label=RST
PC7.Signal=GPIO_Output
PC9.GPIO_Label=LED
PC9.Signal=GPIO_Output
