AdavVegab/LoRaWAN_embeddedSystems/Firmware/FW_Feinstaubmessung/Core/Inc/main.h

#define RST_Pin GPIO_PIN_7
#define RST_GPIO_Port GPIOC
#define LED_Pin GPIO_PIN_9
#define LED_GPIO_Port GPIOC
#define DIO2_Pin GPIO_PIN_8
#define DIO2_GPIO_Port GPIOA
#define DIO2_EXTI_IRQn EXTI9_5_IRQn
#define DIO1_Pin GPIO_PIN_9
#define DIO1_GPIO_Port GPIOA
#define DIO1_EXTI_IRQn EXTI9_5_IRQn
#define DIO0_Pin GPIO_PIN_10
#define DIO0_GPIO_Port GPIOA
#define DIO0_EXTI_IRQn EXTI15_10_IRQn
#define NSS_Pin GPIO_PIN_6
#define NSS_GPIO_Port GPIOB
