AdavVegab/LoRaWAN_embeddedSystems/(commit log)

2019-10-30 test excel
    [Mappe1.xlsx]
2019-10-30 Stückliste von den wichtigsten Teilen
    [ES_Stückliste_G3_30-10-19.xlsx]
2019-10-30 überflüssige testdateien entfernt
    [Mappe1.xlsx]
2019-11-05 schaltplan erstellt
    [ES_Stückliste_G3_30-10-19.xlsx, Mappe1.xlsx, Schaltplan_embedded.kicad_pcb, Schaltplan_embedded.sch, Stückliste_früh_gruppe_3.xlsx, file5DC1A510.sch, file5DCA6AA9.sch]
2019-11-06 Datenblatt für den Battery Charger
2019-11-06 Schaltplan Update und neue Bibliothek
    [Microcontroller.sch, Peripherie.sch, Schaltplan_embedded.kicad_pcb, Schaltplan_embedded.sch, Spannungsversorgung.sch, file5DC1A510.sch, file5DCA6AA9.sch]
2019-11-07 Neuer Schaltplan und Bibiliotheken
    [Microcontroller.sch, Peripherie.sch, Schaltplan_embedded.sch, Spannungsversorgung.sch]
2019-11-13 datenblatt für gps filter
2019-11-13 Revert "datenblatt für gps filter"
    This reverts commit a3d22b48922b2eb581d59a813ce0770eb9a4f51b.
2019-11-13 Neue Stückliste
    [ES_Stückliste_G3_30-10-19.xlsx, Stückliste_früh_gruppe_3.xlsx]
2019-11-13 schaltplan neu
    [GPS.sch, Microcontroller.sch, Peripherie.sch, Schaltplan_embedded.kicad_pcb, Schaltplan_embedded.sch, Sensorik.sch, Spannungsversorgung.sch, file5DC1A510.sch]
2019-11-21 Firs working Version of the Firmware (Nucleo Board)
    [New_configuration (1).cfg, launchConfiguration (1).cfg]
2019-11-21 Neuer Schaltplan
    [ES_Stückliste_G3_30-10-19.xlsx, Microcontroller.sch, Schaltplan_embedded.sch, Sensorik.sch, Spannungsversorgung.sch]
2019-11-23 Bauteilliste vollständig und Schaltplan entsprechend geändert
    [Microcontroller.sch, Schaltplan_embedded.sch, Sensorik.sch, Spannungsversorgung.sch]
2019-11-26 Pin_änderung_KeinPush
    [Microcontroller.sch]
2019-11-26 Firmware stable with new Pin asociations
    [New_configuration (1).cfg, launchConfiguration (1).cfg]
2019-11-28 Schaltplanänderung
    [Sensorik.sch, Spannungsversorgung.sch]
2019-11-28 stabile version
    [Schaltplan_embedded.sch]
2019-11-28 Schaltplan nuevo
    [Microcontroller.sch, Schaltplan_embedded.kicad_pcb, Sensorik.sch]
2019-12-03 pcb erweitert
    [Schaltplan_embedded.kicad_pcb]
2019-12-04 Ruteado semi listo
    [Microcontroller.sch, Schaltplan_embedded.kicad_pcb]
2019-12-05 Firmware for the testing of the Sensors
2019-12-10 Schaltplan vervollständigt mit Massefläche
    [Schaltplan_embedded.kicad_pcb, Spannungsversorgung.sch]
2019-12-10 Präsentation erweitert
    [Schaltplan_embedded.kicad_pcb]
2019-12-10 Cambio tierra
    [Schaltplan_embedded.kicad_pcb]
2019-12-11 Neue platine
    [Microcontroller.sch, Schaltplan_embedded.dsn, Schaltplan_embedded.kicad_pcb, Sensorik.sch]
2019-12-11 git :)
    [ECS-80-12-30Q-DS-TR.stl, ECS-80-12-30Q-DS-TR.stp, Microcontroller.sch, Schaltplan_embedded.kicad_pcb, Sensorik.sch, Spannungsversorgung.sch]
2019-12-11 git fix attempt no. 10231931231410294124
    [Schaltplan_embedded.kicad_pcb]
2019-12-12 PCB decorations / Gerber Files
    [Schaltplan_embedded-B_Cu.gbr, Schaltplan_embedded-B_Mask.gbr, Schaltplan_embedded-B_SilkS.gbr, Schaltplan_embedded-Edge_Cuts.gbr, Schaltplan_embedded-F_Cu.gbr, Schaltplan_embedded-F_Mask.gbr, Schaltplan_embedded-F_SilkS.gbr, Schaltplan_embedded-NPTH.drl]
2019-12-12 Antenna conn change / layout fixes
    [Schaltplan_embedded-B_Cu.gbr, Schaltplan_embedded-B_Mask.gbr, Schaltplan_embedded-B_SilkS.gbr, Schaltplan_embedded-Edge_Cuts.gbr, Schaltplan_embedded-F_Cu.gbr, Schaltplan_embedded-F_Mask.gbr, Schaltplan_embedded-F_SilkS.gbr, Schaltplan_embedded-NPTH.drl]
2019-12-12 Gerber files
    [Microcontroller.sch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]
2019-12-12 Stecker gedreht
    [Schaltplan_embedded.kicad_pcb]
2019-12-12 Berger files
    [Schaltplan_embedded-B_Cu.gbr, Schaltplan_embedded-B_Mask.gbr, Schaltplan_embedded-B_SilkS.gbr, Schaltplan_embedded-Edge_Cuts.gbr, Schaltplan_embedded-F_Cu.gbr, Schaltplan_embedded-F_Mask.gbr, Schaltplan_embedded-F_SilkS.gbr, Schaltplan_embedded-NPTH.drl]
2020-01-22 New library for the Honeywell sensor
2020-01-30 Bug correction in Bitrate of Air sensor
    [FW_Feinstaubmessung.ioc, main.c]
2020-02-01 Gehäuse
    [Base.stl, Case.FCStd, Gehause.FCStd, Top.stl, mitte.stl]
2020-03-13 User configuration corrections, and solved Warnings
    [main.c, user_config.c, user_config.h]
